MunenNoKage/Automatic-Soldering-Station-based-on-ESP32/assets/3d_models/pcb_holder/SlidingRoads.stl

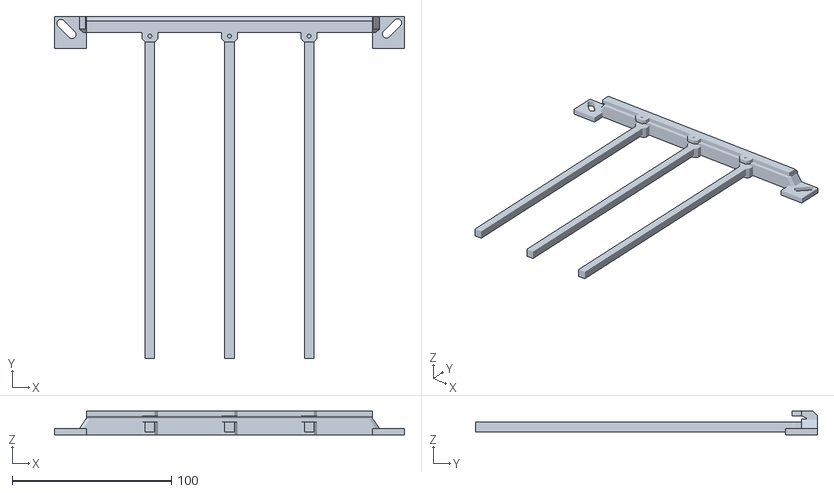
[picture p1: CAD file, 2025-11-20]
assets/3d_models/pcb_holder/SlidingRoads.stl
220.0 x 215.0 x 15.0
