MunenNoKage/Automatic-Soldering-Station-based-on-ESP32/assets/3d_models/pcb_holder/Slider.stl

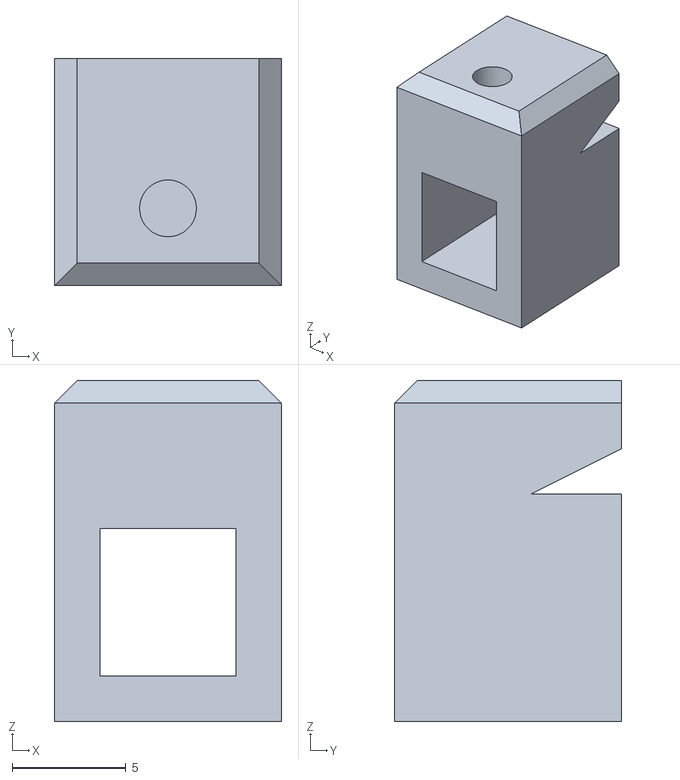
[picture p2: CAD file, 2025-11-20]
assets/3d_models/pcb_holder/Slider.stl
10.0 x 10.0 x 15.0
