MunenNoKage/Automatic-Soldering-Station-based-on-ESP32/assets/3d_models/pcb_holder/base.stl

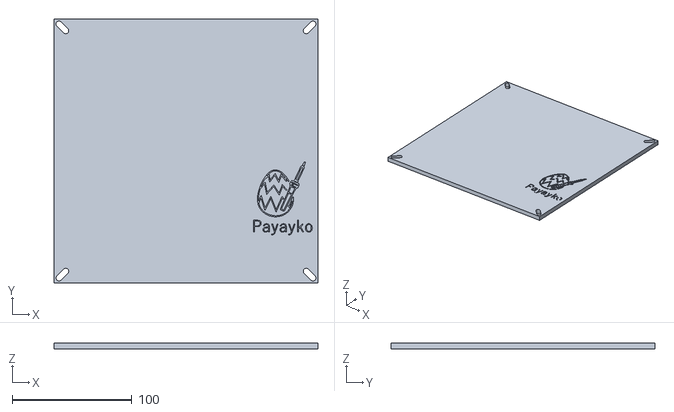
[picture p3: CAD file, 2025-11-20]
assets/3d_models/pcb_holder/base.stl
220.0 x 220.0 x 5.00
