MunenNoKage/Automatic-Soldering-Station-based-on-ESP32/assets/3d_models/pcb_holder/SlidingRoadsCap.stl

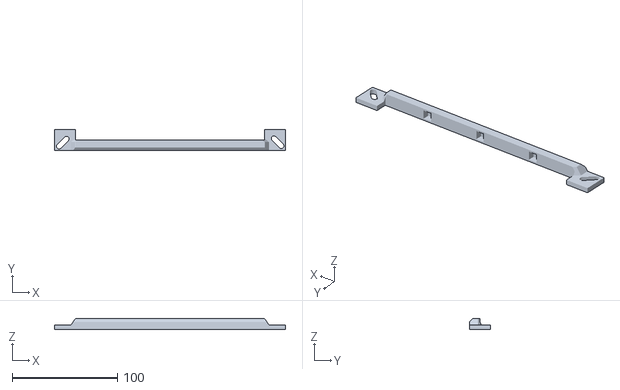
[picture p4: CAD file, 2025-11-20]
assets/3d_models/pcb_holder/SlidingRoadsCap.stl
220.0 x 20.0 x 10.0
