MunenNoKage/Automatic-Soldering-Station-based-on-ESP32/web_interface/manual.html

# Automatic Soldering Station

## Position

X (mm):

Y (mm):

Z (mm):

Set the desired position of the soldering iron's tip by choosing a point on the board above or entering the precise coordinates in the input fields.

## Station control

Calibrate Move to Position Set Origin Here

Test Box Vertices Test Solder Pattern

Feed Solder Take Solder

The origin should be set to the topleft corner of the fixated board. To do this, first move the soldering iron's tip precisely to the board's corner, and then set the origin. Always calibrate before using manual control.

## Heating Control

Current Temperature: --°C

Target Temperature: 450°C

Enable Heating Disable Heating
