MunenNoKage/Automatic-Soldering-Station-based-on-ESP32/assets/automatic_soldering_station_pcb/automatic_soldering_station_pcb.kicad_pcb

## KiCad design assets/automatic_soldering_station_pcb/automatic_soldering_station_pcb.kicad_pcb (2026-04-03)

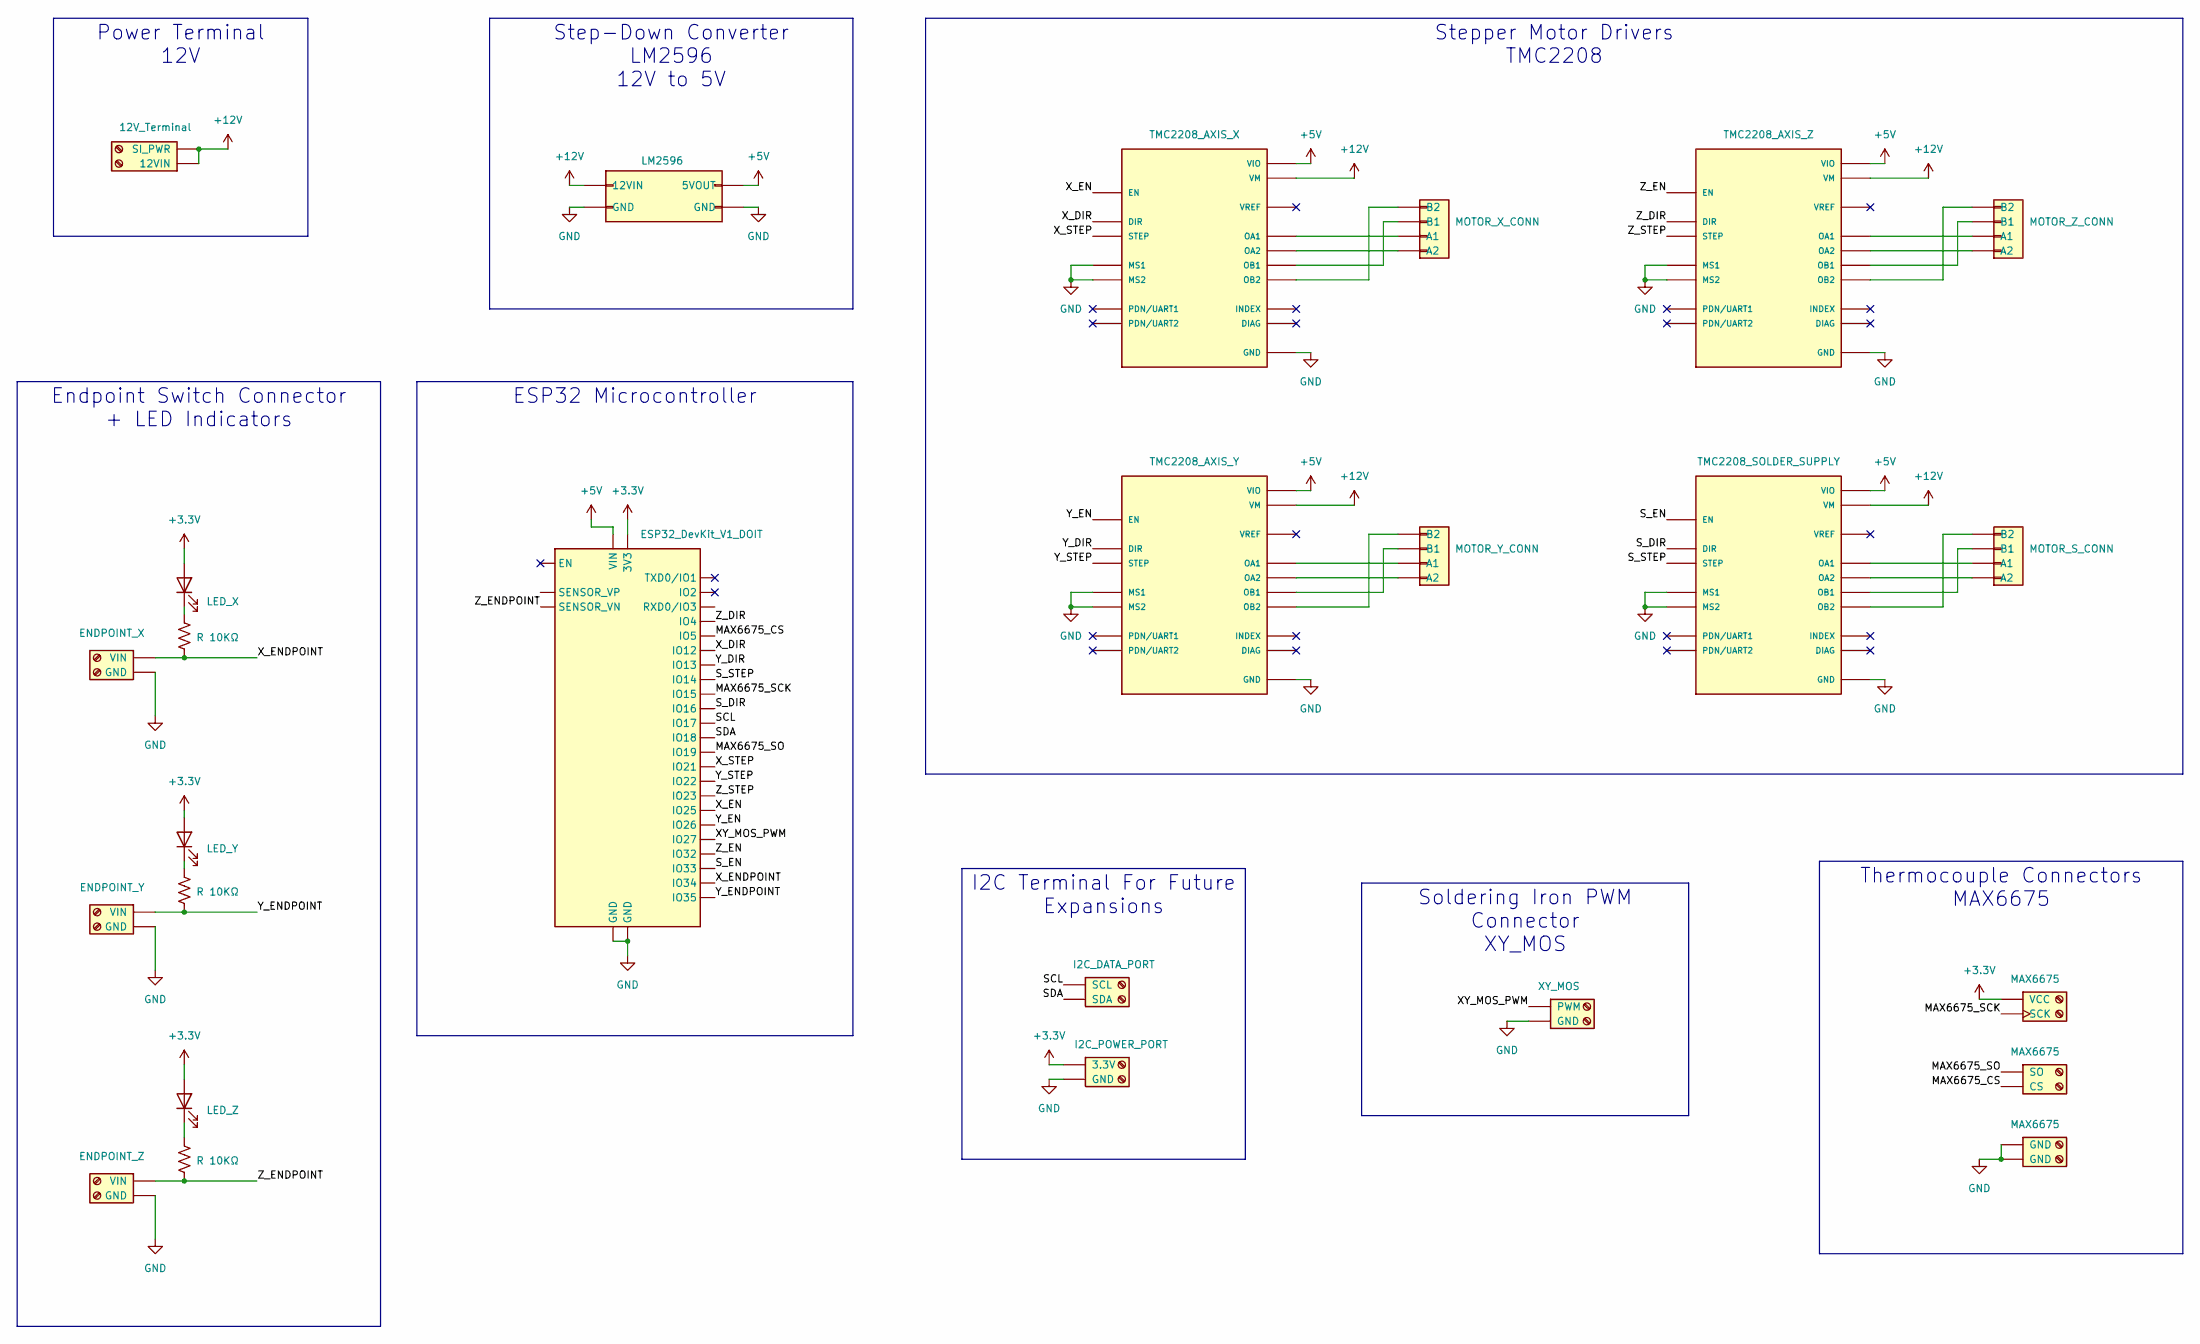
[picture p5: schematic automatic_soldering_station_pcb.kicad_sch]

Parts:
12V2: 12V_Terminal; TerminalBlock_MetzConnect_Type055_RT01502HDWU_1x02_P5.00mm_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
D1: LED_X; LED_D5.0mm
D2: LED_Y; LED_D5.0mm
D3: LED_Z; LED_D5.0mm
ENDPOINT_X1: ENDPOINT_X; TerminalBlock_MetzConnect_Type055_RT01502HDWU_1x02_P5.00mm_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
ENDPOINT_Y1: ENDPOINT_Y; TerminalBlock_MetzConnect_Type055_RT01502HDWU_1x02_P5.00mm_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
ENDPOINT_Y2: I2C_POWER_PORT; TerminalBlock_MetzConnect_Type055_RT01502HDWU_1x02_P5.00mm_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
ENDPOINT_Z1: ENDPOINT_Z; TerminalBlock_MetzConnect_Type055_RT01502HDWU_1x02_P5.00mm_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
ESP32_DevKit_V1_DOIT1: ESP32_DevKit_V1_DOIT; esp32_devkit_v1_doit
J1: XY_MOS; TerminalBlock_MetzConnect_Type055_RT01502HDWU_1x02_P5.00mm_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
J2, J3, J4: MAX6675; TerminalBlock_MetzConnect_Type055_RT01502HDWU_1x02_P5.00mm_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
J5: I2C_DATA_PORT; TerminalBlock_MetzConnect_Type055_RT01502HDWU_1x02_P5.00mm_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
LM2596: LM2596; LM2596_Board
MOTOR_S_CONN1: MOTOR_S_CONN; JST_PH_B4B-PH-K_1x04_P2.00mm_Vertical
MOTOR_X_CONN1: MOTOR_X_CONN; JST_PH_B4B-PH-K_1x04_P2.00mm_Vertical
MOTOR_Y_CONN1: MOTOR_Y_CONN; JST_PH_B4B-PH-K_1x04_P2.00mm_Vertical
MOTOR_Z_CONN1: MOTOR_Z_CONN; JST_PH_B4B-PH-K_1x04_P2.00mm_Vertical
R1, R2, R3: R 10KΩ; R_Axial_DIN0207_L6.3mm_D2.5mm_P7.62mm_Horizontal
TMC2208_AXIS_S1: TMC2208_SOLDER_SUPPLY; MODULE_TMC2208_SILENTSTEPSTICK
TMC2208_AXIS_X1: TMC2208_AXIS_X; MODULE_TMC2208_SILENTSTEPSTICK
TMC2208_AXIS_Y1: TMC2208_AXIS_Y; MODULE_TMC2208_SILENTSTEPSTICK
TMC2208_AXIS_Z1: TMC2208_AXIS_Z; MODULE_TMC2208_SILENTSTEPSTICK

Connections:
+3.3V: D1.2 (A), D2.2 (A), D3.2 (A), ENDPOINT_Y2.1 (3.3V), ESP32_DevKit_V1_DOIT1.16 (3V3), J3.1 (VCC)
+5V: ESP32_DevKit_V1_DOIT1.15 (VIN), LM2596.2 (5VOUT), TMC2208_AXIS_S1.JP2_7 (VIO), TMC2208_AXIS_X1.JP2_7 (VIO), TMC2208_AXIS_Y1.JP2_7 (VIO), TMC2208_AXIS_Z1.JP2_7 (VIO)
+12V: 12V2.1 (12VIN), 12V2.2 (SI_PWR), LM2596.0 (12VIN), TMC2208_AXIS_S1.JP2_1 (VM), TMC2208_AXIS_X1.JP2_1 (VM), TMC2208_AXIS_Y1.JP2_1 (VM), TMC2208_AXIS_Z1.JP2_1 (VM)
/MAX6675_CS: ESP32_DevKit_V1_DOIT1.23 (IO5), J4.2 (CS)
/MAX6675_SCK: ESP32_DevKit_V1_DOIT1.18 (IO15), J3.2 (SCK)
/MAX6675_SO: ESP32_DevKit_V1_DOIT1.25 (IO19), J4.1 (SO)
/SCL: ESP32_DevKit_V1_DOIT1.22 (IO17), J5.1 (SCL)
/SDA: ESP32_DevKit_V1_DOIT1.24 (IO18), J5.2 (SDA)
/S_DIR: ESP32_DevKit_V1_DOIT1.21 (IO16), TMC2208_AXIS_S1.JP1_1 (DIR)
/S_EN: ESP32_DevKit_V1_DOIT1.7 (IO33), TMC2208_AXIS_S1.JP1_8 (EN)
/S_STEP: ESP32_DevKit_V1_DOIT1.11 (IO14), TMC2208_AXIS_S1.JP1_2 (STEP)
/XY_MOS_PWM: ESP32_DevKit_V1_DOIT1.10 (IO27), J1.1 (PWM)
/X_DIR: ESP32_DevKit_V1_DOIT1.12 (IO12), TMC2208_AXIS_X1.JP1_1 (DIR)
/X_EN: ESP32_DevKit_V1_DOIT1.8 (IO25), TMC2208_AXIS_X1.JP1_8 (EN)
/X_ENDPOINT: ENDPOINT_X1.1 (VIN), ESP32_DevKit_V1_DOIT1.4 (IO34), R1.2
/X_STEP: ESP32_DevKit_V1_DOIT1.26 (IO21), TMC2208_AXIS_X1.JP1_2 (STEP)
/Y_DIR: ESP32_DevKit_V1_DOIT1.13 (IO13), TMC2208_AXIS_Y1.JP1_1 (DIR)
/Y_EN: ESP32_DevKit_V1_DOIT1.9 (IO26), TMC2208_AXIS_Y1.JP1_8 (EN)
/Y_ENDPOINT: ENDPOINT_Y1.1 (VIN), ESP32_DevKit_V1_DOIT1.5 (IO35), R2.2
/Y_STEP: ESP32_DevKit_V1_DOIT1.29 (IO22), TMC2208_AXIS_Y1.JP1_2 (STEP)
/Z_DIR: ESP32_DevKit_V1_DOIT1.20 (IO4), TMC2208_AXIS_Z1.JP1_1 (DIR)
/Z_EN: ESP32_DevKit_V1_DOIT1.6 (IO32), TMC2208_AXIS_Z1.JP1_8 (EN)
/Z_ENDPOINT: ENDPOINT_Z1.1 (VIN), ESP32_DevKit_V1_DOIT1.3 (SENSOR_VN), R3.2
/Z_STEP: ESP32_DevKit_V1_DOIT1.30 (IO23), TMC2208_AXIS_Z1.JP1_2 (STEP)
GND: ENDPOINT_X1.2 (GND), ENDPOINT_Y1.2 (GND), ENDPOINT_Y2.2 (GND), ENDPOINT_Z1.2 (GND), ESP32_DevKit_V1_DOIT1.14 (GND), ESP32_DevKit_V1_DOIT1.17 (GND), J1.2 (GND), J2.1 (GND), J2.2 (GND), LM2596.1 (GND), LM2596.3 (GND), TMC2208_AXIS_S1.JP1_6 (MS2), TMC2208_AXIS_S1.JP1_7 (MS1), TMC2208_AXIS_S1.JP2_2 (GND), TMC2208_AXIS_S1.JP2_8 (GND), TMC2208_AXIS_X1.JP1_6 (MS2), TMC2208_AXIS_X1.JP1_7 (MS1), TMC2208_AXIS_X1.JP2_2 (GND), TMC2208_AXIS_X1.JP2_8 (GND), TMC2208_AXIS_Y1.JP1_6 (MS2), TMC2208_AXIS_Y1.JP1_7 (MS1), TMC2208_AXIS_Y1.JP2_2 (GND), TMC2208_AXIS_Y1.JP2_8 (GND), TMC2208_AXIS_Z1.JP1_6 (MS2), TMC2208_AXIS_Z1.JP1_7 (MS1), TMC2208_AXIS_Z1.JP2_2 (GND), TMC2208_AXIS_Z1.JP2_8 (GND)
unnamed: D1.1 (K), R1.1
unnamed: D2.1 (K), R2.1
unnamed: D3.1 (K), R3.1
unnamed: MOTOR_S_CONN1.2 (A1), TMC2208_AXIS_S1.JP2_4 (OA1)
unnamed: MOTOR_S_CONN1.1 (A2), TMC2208_AXIS_S1.JP2_3 (OA2)
unnamed: MOTOR_S_CONN1.3 (B1), TMC2208_AXIS_S1.JP2_5 (OB1)
unnamed: MOTOR_S_CONN1.4 (B2), TMC2208_AXIS_S1.JP2_6 (OB2)
unnamed: MOTOR_X_CONN1.2 (A1), TMC2208_AXIS_X1.JP2_4 (OA1)
unnamed: MOTOR_X_CONN1.1 (A2), TMC2208_AXIS_X1.JP2_3 (OA2)
unnamed: MOTOR_X_CONN1.3 (B1), TMC2208_AXIS_X1.JP2_5 (OB1)
unnamed: MOTOR_X_CONN1.4 (B2), TMC2208_AXIS_X1.JP2_6 (OB2)
unnamed: MOTOR_Y_CONN1.2 (A1), TMC2208_AXIS_Y1.JP2_4 (OA1)
unnamed: MOTOR_Y_CONN1.1 (A2), TMC2208_AXIS_Y1.JP2_3 (OA2)
unnamed: MOTOR_Y_CONN1.3 (B1), TMC2208_AXIS_Y1.JP2_5 (OB1)
unnamed: MOTOR_Y_CONN1.4 (B2), TMC2208_AXIS_Y1.JP2_6 (OB2)
unnamed: MOTOR_Z_CONN1.2 (A1), TMC2208_AXIS_Z1.JP2_4 (OA1)
unnamed: MOTOR_Z_CONN1.1 (A2), TMC2208_AXIS_Z1.JP2_3 (OA2)
unnamed: MOTOR_Z_CONN1.3 (B1), TMC2208_AXIS_Z1.JP2_5 (OB1)
unnamed: MOTOR_Z_CONN1.4 (B2), TMC2208_AXIS_Z1.JP2_6 (OB2)

Notes on the sheet:
Step-Down Converter LM2596 12V to 5V
ESP32 Microcontroller
Endpoint Switch Connector + LED Indicators
I2C Terminal For Future Expansions
Thermocouple Connectors MAX6675
Soldering Iron PWM Connector XY_MOS
Power Terminal 12V
Stepper Motor Drivers TMC2208

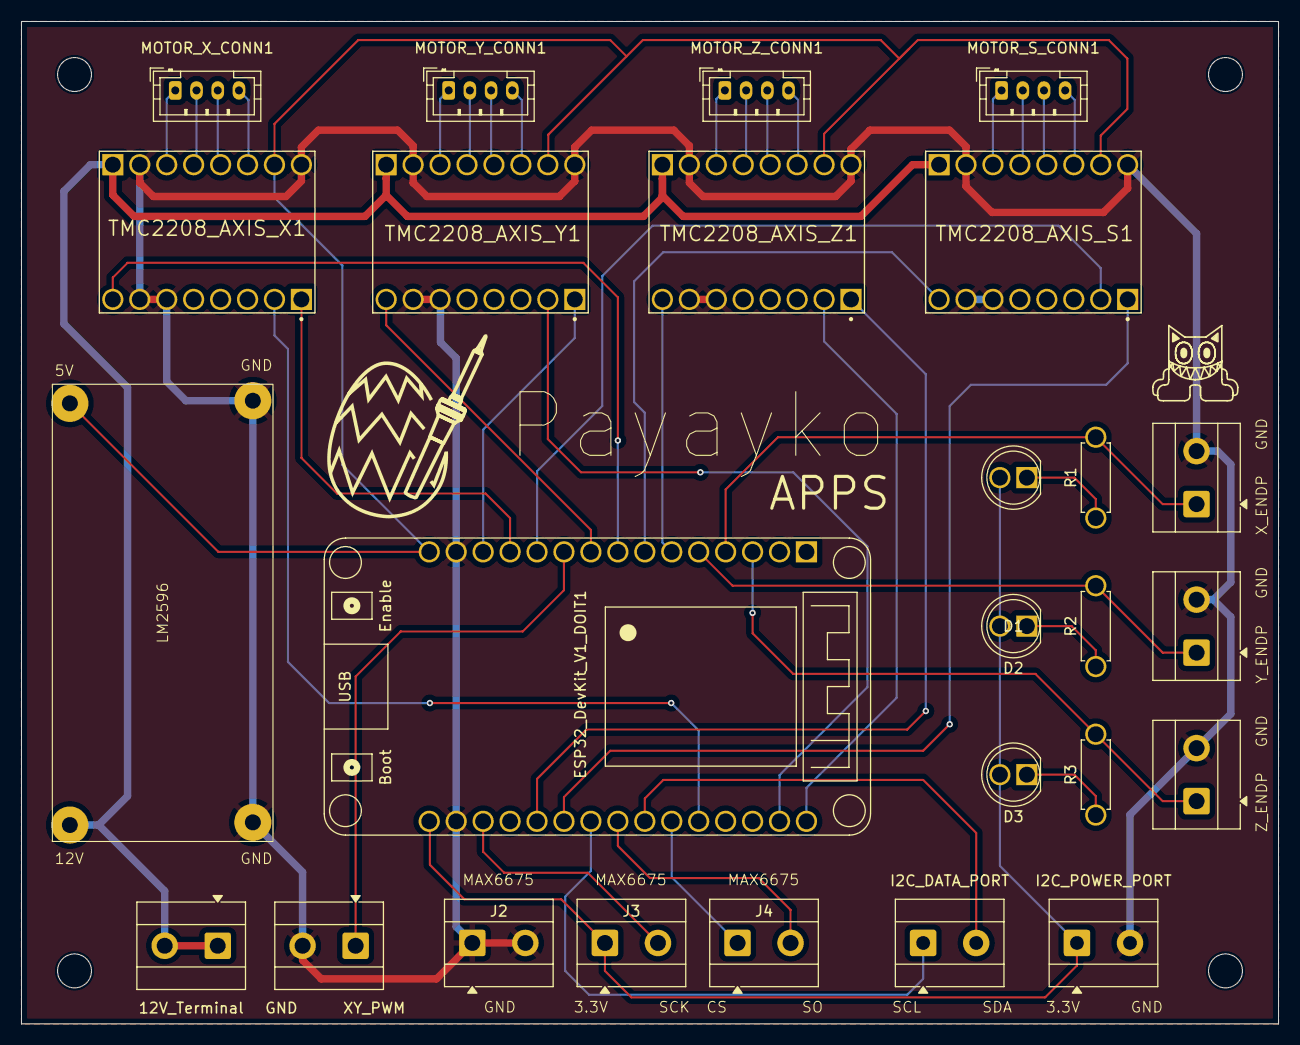
[picture p6: board automatic_soldering_station_pcb.kicad_pcb from above]

Board: 2 copper layers, 118.5 x 94.5 mm, 30 parts (0 on the bottom side), 44 nets.

Other parts of the board:
H1, H2, H3, H4: MountingHole_3.2mm_M3
