MunenNoKage/Automatic-Soldering-Station-based-on-ESP32/components/temperature_sensor/include/pins.h

#ifndef _pins_h
#define _pins_h

#define PIN_NUM_MISO 19
#define PIN_NUM_MOSI -1
#define PIN_NUM_CLK 18
#define PIN_NUM_CS 5

#endif
