MunenNoKage/Automatic-Soldering-Station-based-on-ESP32/(commit log)

2025-11-20 chore: update 3d models for pcb holder
    [Slider.stl, SlidingRoads.stl, SlidingRoadsCap.stl, base.stl]
2025-11-23 feat: make calibration and movements faster, fix calibration glitch on endpoint
    [StepperMotor.cpp, main.cpp, stepper_motor_hal.c, stepper_motor_hal.h]
2025-11-23 pcb: add pcb project with complete project scheme
    [automatic_soldering_station_pcb.kicad_pcb, automatic_soldering_station_pcb.kicad_sch]
2025-11-30 pcb: add autorouted results
    [automatic_soldering_station_pcb.kicad_pcb, automatic_soldering_station_pcb.kicad_sch]
2025-12-01 pcb: add buck converter and reroute pcb manually
    [automatic_soldering_station_pcb.kicad_pcb, automatic_soldering_station_pcb.kicad_sch]
2025-12-08 pcb: polish routing
    [automatic_soldering_station_pcb.kicad_pcb]
2025-12-08 pcb: fix printer specific mistakes
    [automatic_soldering_station_pcb.kicad_pcb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]
2025-12-09 pcb: reduce size of pcb
    [automatic_soldering_station_pcb.kicad_pcb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]
2025-12-09 chore: add max measured motor positions to Kconfig
2025-12-09 feat: board visualization and real-time position tracking
2025-12-12 feat: add manual solder feed control
2025-12-12 fix: 💊 🐷 🕑
    [main.cpp]
2026-01-09 pcb: add I2C terminal to schematic
    [automatic_soldering_station_pcb.kicad_pcb, automatic_soldering_station_pcb.kicad_sch]
2026-01-09 chore: add kicad temporally files to .gitignore
2026-01-09 pcb: update components placement and reduce pcb size
    [automatic_soldering_station_pcb.kicad_pcb]
2026-01-09 pcb: change pcb for China manufacturing
    [automatic_soldering_station_pcb.kicad_pcb]
2026-01-11 pcb: change power traces width from 0.2 to 0.7mm, update gerber files
    [automatic_soldering_station_pcb-B_Cu.gbl, automatic_soldering_station_pcb-B_Mask.gbs, automatic_soldering_station_pcb-B_Paste.gbp, automatic_soldering_station_pcb-B_Silkscreen.gbo, automatic_soldering_station_pcb-Edge_Cuts.gm1, automatic_soldering_station_pcb-F_Cu.gtl, automatic_soldering_station_pcb-F_Mask.gts, automatic_soldering_station_pcb-F_Paste.gtp]
2026-01-11 pcb: add ground plane
    [automatic_soldering_station_pcb-B_Cu.gbl, automatic_soldering_station_pcb-B_Mask.gbs, automatic_soldering_station_pcb-B_Paste.gbp, automatic_soldering_station_pcb-B_Silkscreen.gbo, automatic_soldering_station_pcb-Edge_Cuts.gm1, automatic_soldering_station_pcb-F_Cu.gtl, automatic_soldering_station_pcb-F_Mask.gts, automatic_soldering_station_pcb-F_Paste.gtp]
2026-01-11 pcb: small fixes of ground plane
    [automatic_soldering_station_pcb-B_Cu.gbl, automatic_soldering_station_pcb-B_Mask.gbs, automatic_soldering_station_pcb-B_Paste.gbp, automatic_soldering_station_pcb-B_Silkscreen.gbo, automatic_soldering_station_pcb-Edge_Cuts.gm1, automatic_soldering_station_pcb-F_Cu.gtl, automatic_soldering_station_pcb-F_Mask.gts, automatic_soldering_station_pcb-F_Paste.gtp]
2026-01-24 feat: Tracking temperature during execution & Add navigation buttons
2026-01-24 feat: Implement temperature tracking & Heating control
2026-01-24 fix: Implement transitions from heating
    [web_server.cpp]
2026-01-27 web: add Take Solder button
2026-01-29 fix: change the order of calibration
    [execution_fsm.cpp, fsm_callbacks.cpp]
2026-02-01 changed pins for temperature sensor
2026-04-03 pcb: add pcb output files
    [automatic_soldering_station_pcb-B_Cu.gbl, automatic_soldering_station_pcb-B_Mask.gbs, automatic_soldering_station_pcb-B_Paste.gbp, automatic_soldering_station_pcb-B_Silkscreen.gbo, automatic_soldering_station_pcb-Edge_Cuts.gm1, automatic_soldering_station_pcb-F_Cu.gtl, automatic_soldering_station_pcb-F_Mask.gts, automatic_soldering_station_pcb-F_Paste.gtp]
2026-04-03 feat: add test sequences
    NOTE: THERE IS BUG that watchdog is triggered in test sequences, but they managed to complete despite that
    [web_server.cpp]
